0mrrabbit0/Smart_Water_Bottle/Doc/TDS.pdf

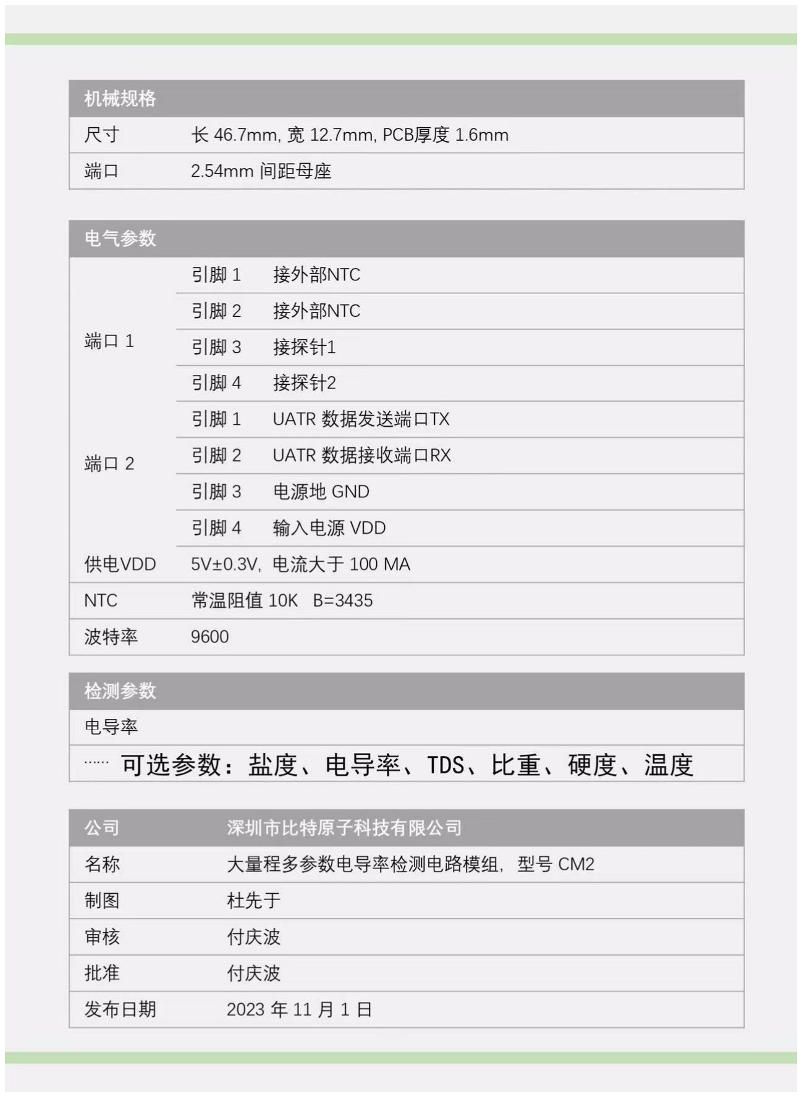
[picture p4: figure]

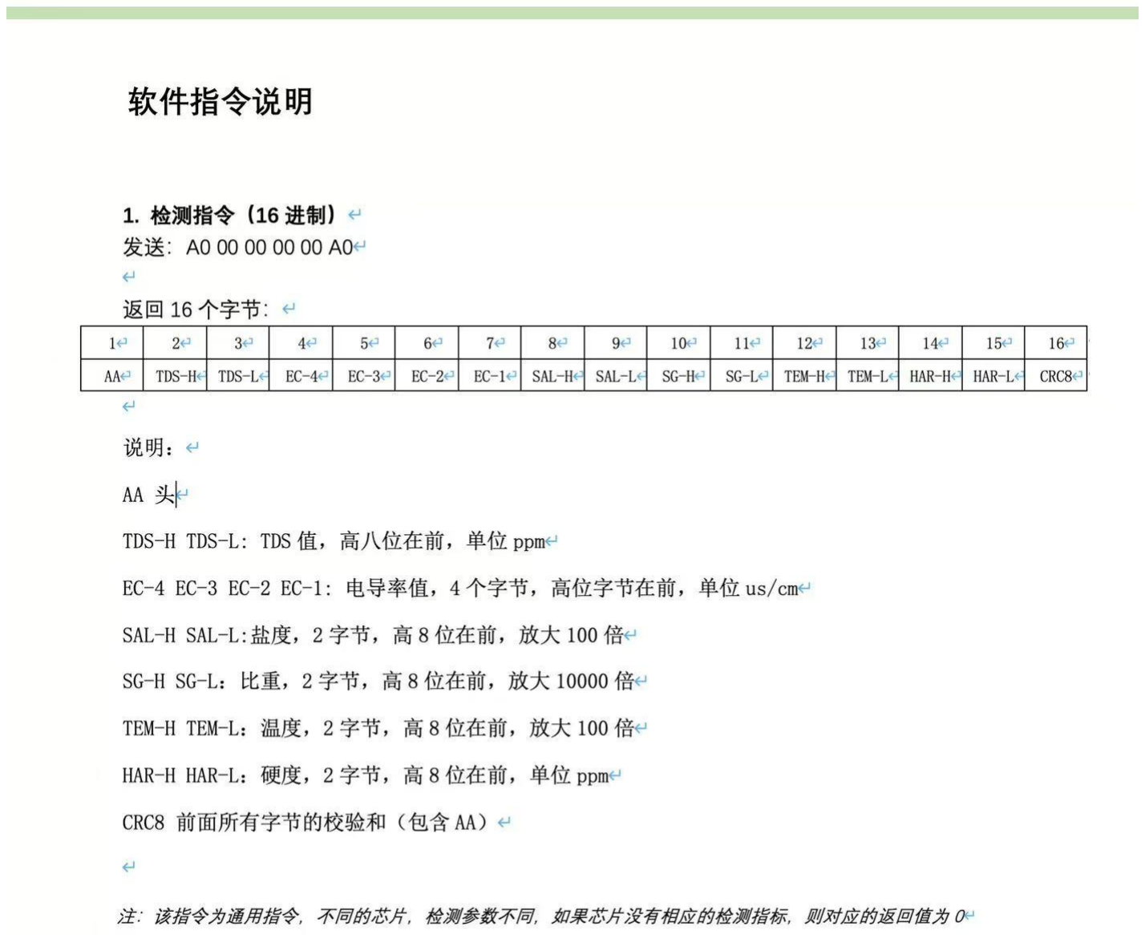
[picture p5: figure]

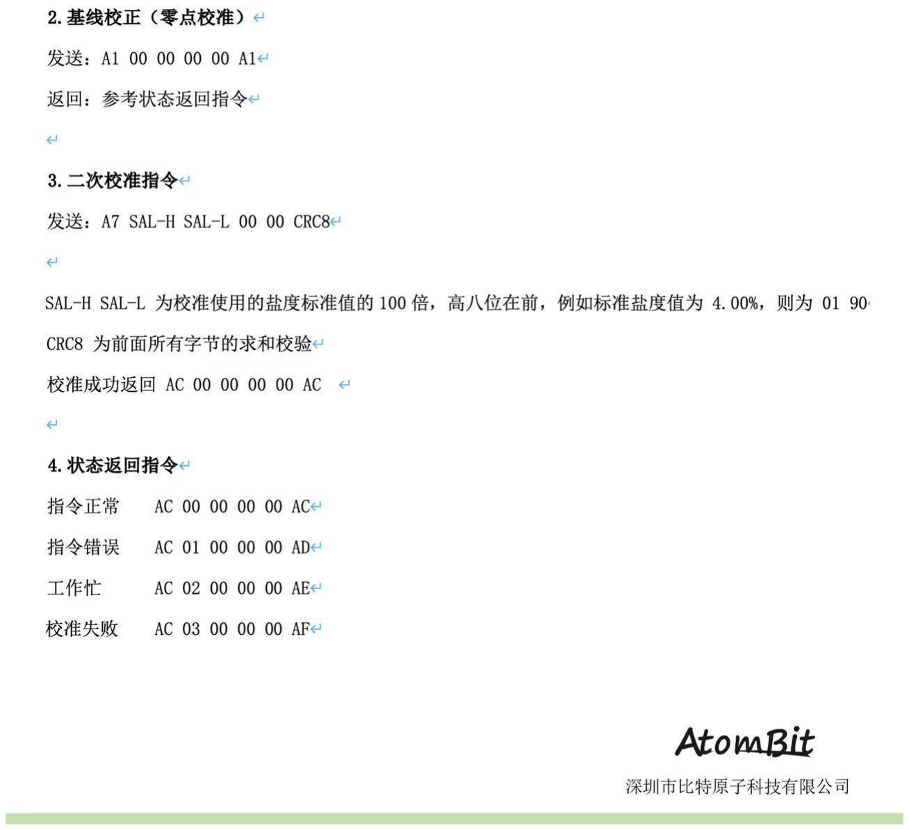
[picture p6: figure]
