0mrrabbit0/Smart_Water_Bottle/Doc/business_flowchart.png

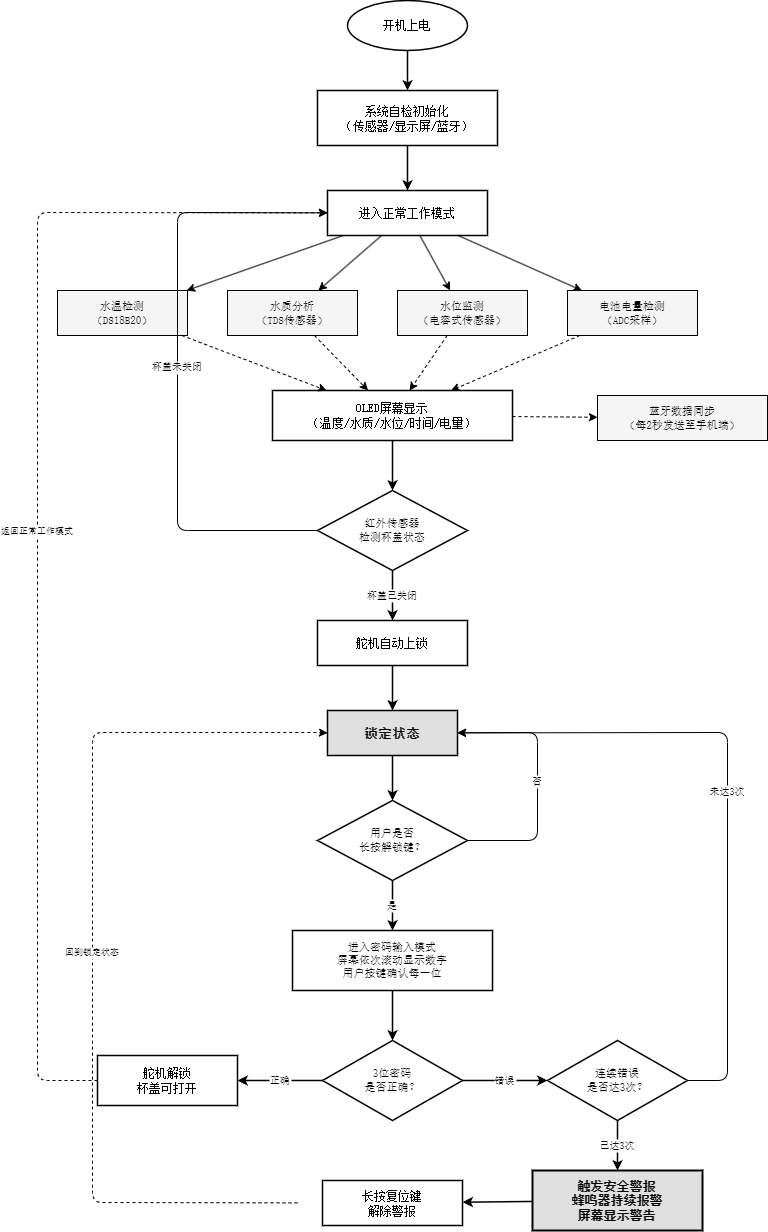
Doc/business_flowchart.png
