0mrrabbit0/Smart_Water_Bottle/Doc/Src/bat.jpg

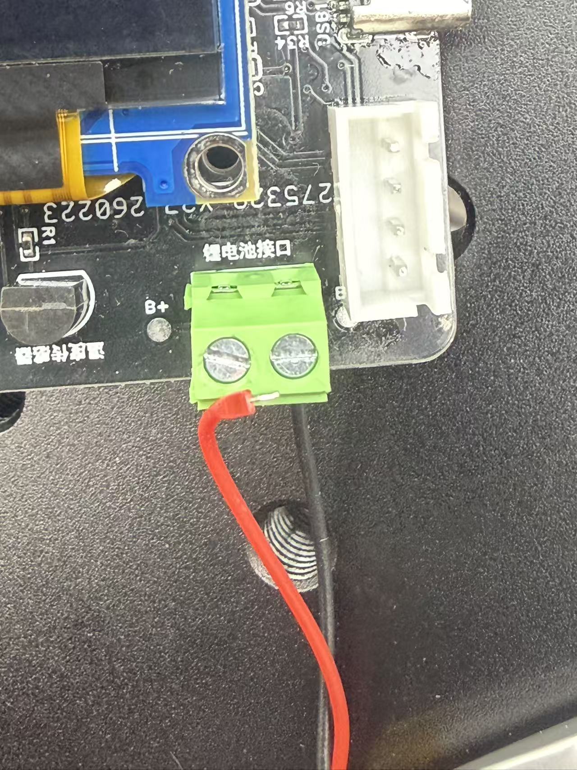
Doc/Src/bat.jpg
