0mrrabbit0/Smart_Water_Bottle/Core/Src/main.c

/**
 * @file    main.c
 * @brief   Smart Water Bottle main entry
 */

#include "main.h"
#include "bsp.h"
#include "app_task.h"
#include "FreeRTOS.h"
#include "task.h"

void SystemClock_Config(void);

int main(void)
{
    HAL_Init();
    SystemClock_Config();

    BSP_Init();

    App_Task_Create();
    vTaskStartScheduler();

    while (1) {
    }
}

/**
 * @brief System clock: HSI 8MHz / 2 x PLL16 = 64MHz SYSCLK
 */
void SystemClock_Config(void)
{
    RCC_OscInitTypeDef RCC_OscInitStruct = {0};
    RCC_ClkInitTypeDef RCC_ClkInitStruct = {0};

    RCC_OscInitStruct.OscillatorType = RCC_OSCILLATORTYPE_HSI;
    RCC_OscInitStruct.HSIState = RCC_HSI_ON;
    RCC_OscInitStruct.HSICalibrationValue = RCC_HSICALIBRATION_DEFAULT;
    RCC_OscInitStruct.PLL.PLLState = RCC_PLL_ON;
    RCC_OscInitStruct.PLL.PLLSource = RCC_PLLSOURCE_HSI_DIV2;
    RCC_OscInitStruct.PLL.PLLMUL = RCC_PLL_MUL16;
    if (HAL_RCC_OscConfig(&RCC_OscInitStruct) != HAL_OK)
    {
        Error_Handler();
    }

    RCC_ClkInitStruct.ClockType = RCC_CLOCKTYPE_HCLK | RCC_CLOCKTYPE_SYSCLK
                                | RCC_CLOCKTYPE_PCLK1 | RCC_CLOCKTYPE_PCLK2;
    RCC_ClkInitStruct.SYSCLKSource = RCC_SYSCLKSOURCE_PLLCLK;
    RCC_ClkInitStruct.AHBCLKDivider = RCC_SYSCLK_DIV1;
    RCC_ClkInitStruct.APB1CLKDivider = RCC_HCLK_DIV2;
    RCC_ClkInitStruct.APB2CLKDivider = RCC_HCLK_DIV1;

    if (HAL_RCC_ClockConfig(&RCC_ClkInitStruct, FLASH_LATENCY_2) != HAL_OK)
    {
        Error_Handler();
    }
}

void vApplicationStackOverflowHook(TaskHandle_t xTask, char *pcTaskName)
{
    (void)xTask;
    (void)pcTaskName;
    while (1) {
    }
}

void Error_Handler(void)
{
    __disable_irq();
    while (1) {
    }
}

#ifdef USE_FULL_ASSERT
void assert_failed(uint8_t *file, uint32_t line)
{
    (void)file;
    (void)line;
}
#endif
