0mrrabbit0/Smart_Water_Bottle/BSP/Inc/bsp_oled_font.h

/**
 * @file    bsp_oled_font.h
 * @brief   OLED font data - 6x8 and 8x16 ASCII fonts
 */

#ifndef __BSP_OLED_FONT_H__
#define __BSP_OLED_FONT_H__

#include <stdint.h>

/* 6x8 ASCII font, characters 0x20-0x7F (96 chars), 6 bytes each */
static const uint8_t F6x8[][6] = {
    {0x00,0x00,0x00,0x00,0x00,0x00}, /* SP  0x20 */
    {0x00,0x00,0x5F,0x00,0x00,0x00}, /* !   0x21 */
    {0x00,0x07,0x00,0x07,0x00,0x00}, /* "   0x22 */
    {0x14,0x7F,0x14,0x7F,0x14,0x00}, /* #   0x23 */
    {0x24,0x2A,0x7F,0x2A,0x12,0x00}, /* $   0x24 */
    {0x23,0x13,0x08,0x64,0x62,0x00}, /* %   0x25 */
    {0x36,0x49,0x55,0x22,0x50,0x00}, /* &   0x26 */
    {0x00,0x05,0x03,0x00,0x00,0x00}, /* '   0x27 */
    {0x00,0x1C,0x22,0x41,0x00,0x00}, /* (   0x28 */
    {0x00,0x41,0x22,0x1C,0x00,0x00}, /* )   0x29 */
    {0x08,0x2A,0x1C,0x2A,0x08,0x00}, /* *   0x2A */
    {0x08,0x08,0x3E,0x08,0x08,0x00}, /* +   0x2B */
    {0x00,0x50,0x30,0x00,0x00,0x00}, /* ,   0x2C */
    {0x08,0x08,0x08,0x08,0x08,0x00}, /* -   0x2D */
    {0x00,0x60,0x60,0x00,0x00,0x00}, /* .   0x2E */
    {0x20,0x10,0x08,0x04,0x02,0x00}, /* /   0x2F */
    {0x3E,0x51,0x49,0x45,0x3E,0x00}, /* 0   0x30 */
    {0x00,0x42,0x7F,0x40,0x00,0x00}, /* 1   0x31 */
    {0x42,0x61,0x51,0x49,0x46,0x00}, /* 2   0x32 */
    {0x21,0x41,0x45,0x4B,0x31,0x00}, /* 3   0x33 */
    {0x18,0x14,0x12,0x7F,0x10,0x00}, /* 4   0x34 */
    {0x27,0x45,0x45,0x45,0x39,0x00}, /* 5   0x35 */
    {0x3C,0x4A,0x49,0x49,0x30,0x00}, /* 6   0x36 */
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
    {0x08,0xF8,0x08,0x00,0x00,0x08,0xF8,0x08,0x20,0x3F,0x21,0x01,0x01,0x21,0x3F,0x20}, /* H */
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
    {0x00,0x00,0x00,0x00,0x00,0x00,0x00,0x00,0x00,0x00,0x00,0x00,0x00,0x00,0x00,0x00}, /* DEL */
};

#endif /* __BSP_OLED_FONT_H__ */
