0mrrabbit0/Smart_Water_Bottle/Core/Inc/main.h

/**
 * @file    main.h
 * @brief   Main program header
 */

#ifndef __MAIN_H
#define __MAIN_H

#ifdef __cplusplus
extern "C" {
#endif

#include "stm32f1xx_hal.h"
#include "app_config.h"

void Error_Handler(void);

#ifdef __cplusplus
}
#endif

#endif
