0mrrabbit0/Smart_Water_Bottle/(commit log)

2026-03-03 Initial commit: Smart Water Bottle full project
    STM32F103C8T6 + FreeRTOS + HAL, BSP/App 3-layer architecture.
    Features: DS18B20 temp, TDS water quality, M04 water level x3,
    SSD1306 OLED, RTC, servo lock, password unlock, buzzer alarm,
    HC-05 Bluetooth, battery monitoring, debug UART key simulation.
    [Smart_Water_Bottle.ioc]
2026-03-31 feat: 添加智能水杯微信小程序完整项目
    - 设计文档: 完整的功能设计、架构、数据模型、BLE协议、UI规范
    - 小程序前端: 7个页面(首页仪表盘/饮水记录/水质分析/个人中心/设备管理/统计/成就)
    - 6个自定义组件: 进度环/数据卡片/水位动画/蓝牙状态/水质仪表/饮水时间线
    - 服务层: BLE蓝牙通信(SWB协议解析)、云开发API封装、自动饮水检测、通知服务
    - 8个云函数: 饮水记录/每日汇总/周月统计/目标管理/排行榜/成就检测/定时提醒
    - 图标资源: Remix Icon (MIT协议) TabBar及功能图标
2026-04-04 fix: switch clock source from HSE to HSI to resolve startup hang
    HSE crystal oscillator failed to start (likely hardware soldering issue),
    causing Error_Handler() during SystemClock_Config(). Changed to internal
    HSI + PLL (HSI/2 × 16 = 64MHz) to bypass external crystal dependency.
    [main.c]
2026-04-05 fix: IR传感器引脚迁移PA7→PA1，水位改2级，OLED I2C驱动优化
    - IR sensor: PA7/ADC_CH7 → PA1/ADC_CH1
    - Water level: 3级→2级 (PB0 Low + PB1 High)
    - FreeRTOS: configCPU_CLOCK_HZ 72→64MHz (match HSI), heap 10→12KB
    - OLED: 保留shadow buffer + dirty page跳过 + batch I2C传输
    [bsp_gpio.c, bsp_gpio.h, bsp_water_level.c]
2026-04-11 docs: 添加README、系统架构图和业务流程图，清理冗余文件
    - 新增 README.md 项目说明文档
    - 新增 Doc/system_flowchart.drawio 系统架构流程图
    - 新增 Doc/business_flowchart.drawio 业务流程图
    - 删除 HANDOFF.md、README_OLED_SIMULATOR.md 等冗余文档
    - 删除 miniprogram/ 微信小程序目录（暂不使用）
    - 更新 Keil 工程配置文件
2026-04-17 docs: 完善 README 操作说明，新增图片视频素材，规范化代码注释
    - README: 新增 SOP 级操作说明（开机/按键/TDS 检测/水位检测/自动上锁/密码解锁/警报复位/充电/蓝牙/完整流程演示/常见问题）
    - 新增 Doc/Src/ 演示素材：TDS1/2.jpg、level.jpg、bat.jpg、BT.mp4、compelte.mp4
    - 移动 TDS.pdf 至 Doc/ 目录归档
    - 修正 main.c、FreeRTOSConfig.h、bsp_servo.c 中的时钟描述（实际为 HSI 64MHz）
    - 修正 bsp_water_level 文档（2 级检测，0=Empty/1=Low/2=Full）
    - 精简 BSP 与 App 层代码注释，统一风格，删除冗余/历史性说明
    [bsp_battery.c, bsp_battery.h, bsp_debug_uart.c, bsp_gpio.h]
2026-05-02 restore: 恢复 miniprogram 微信小程序目录
